andresv/ccbee/(commit log)

2012-01-05 Added hardware
    [CCBee.brd, CCBee.sch]
2012-01-05 Revert "Added hardware"
    This reverts commit 4b2d32e4849250ba98a27b95701208aef322db12.
    [CCBee.brd, CCBee.sch]
2012-01-05 Revert "Revert "Added hardware""
    This reverts commit 521494e9ccdca5ef7948ae36c308c9be86bbb1f4.
    [CCBee.brd, CCBee.sch]
2012-01-19 Main components added to BOM
2012-01-19 Added capacitors to BOM.
2012-01-19 BOM finished.
2012-01-22 Added 2 mm x 10 pins socket to BOM.
2012-01-22 Corrected BOM - Xbee uses pinheader not female.
2012-01-27 Added information about board thickness.
2012-02-18 Fixed 26 MHz crystal silkscreen
    [CCBee.brd, CCBee.sch]
2012-03-08 Fixes #1 Wrong configuration was used for 868 MHz settings.
    [Rf1aConfigure.h]
2012-04-23 Enabled Uart Rx interrupt.
2012-08-05 Added Leds to BridgeStation and reworked coding style a little.
2014-02-06 #7 ccbee now compiles with current tp-prod HEAD
